c20d-us/Gnimu-PCB/README.md

<p>
  Gnimu icon
  <picture>
    <source media="(prefers-color-scheme: dark)" srcset="https://raw.githubusercontent.com/c20d-us/Gnimu-branding/main/wordmark/gnimu-wordmark-transparent-white.svg">
    gnimu
  </picture>
</p>

# Gnimu PCBs





Circuit boards for [Gnimu](https://github.com/c20d-us/Gnimu), a GNSS+IMU motorsports telemetry device that streams live position, speed, and motion data over BLE.

This repository holds the hardware only: KiCad projects, the shared symbol and footprint library, and fabrication outputs. The firmware, the bill of materials, and the step-by-step build guides live in the [Gnimu](https://github.com/c20d-us/Gnimu) repository.

<table>
  <tr>
    <td align="center" valign="top" width="50%">
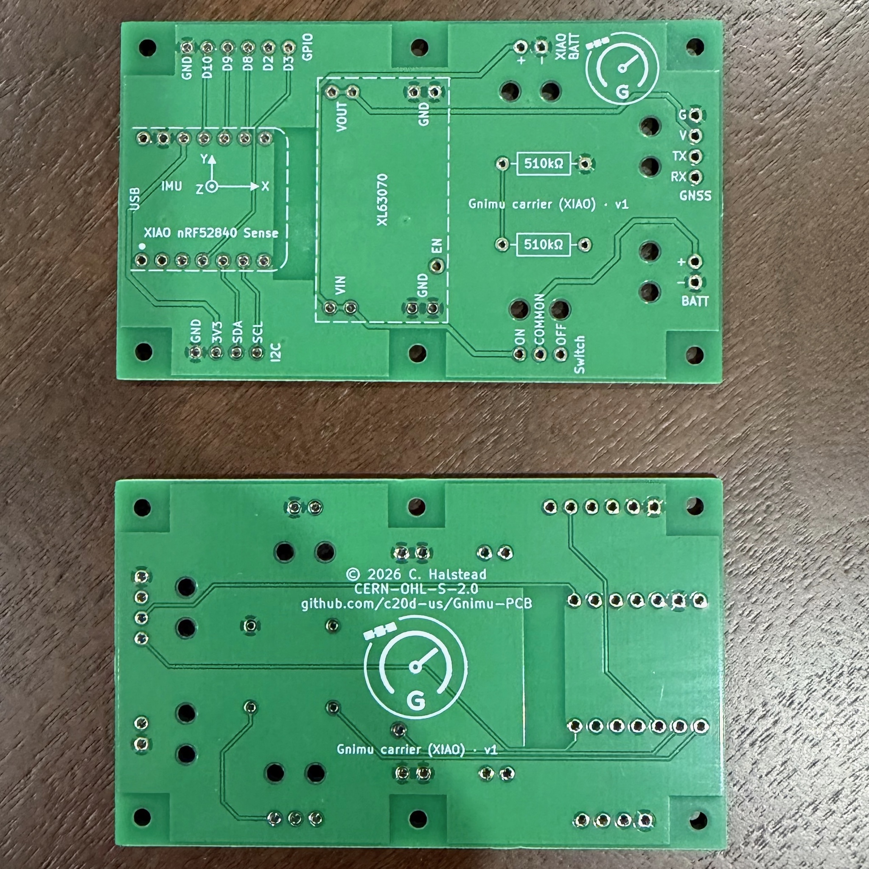
[picture p1: images/gnimu-carrier-xiao-v1-bare-pcb.jpeg]
The bare Gnimu carrier PCB, front and back
      <br>
      <sub>The bare carrier (revision v1.0), front and back.</sub>
    </td>
    <td align="center" valign="top" width="50%">
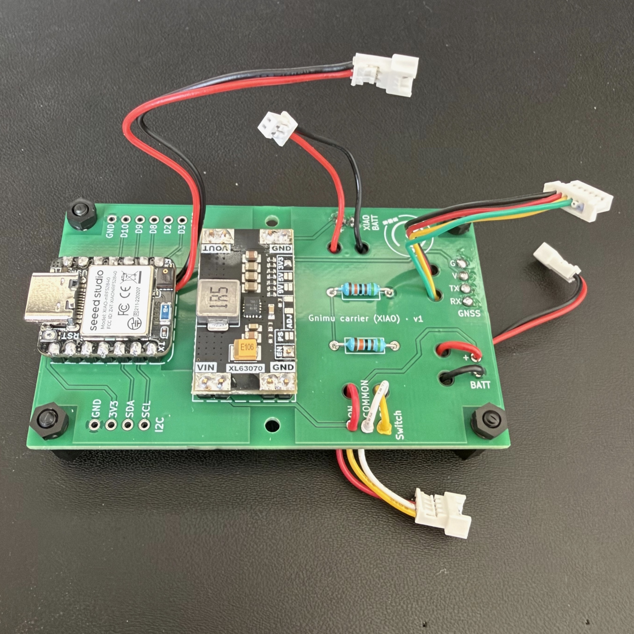
[picture p2: images/gnimu-carrier-xiao-v1-loaded-pcb.jpeg]
The Gnimu carrier PCB with the XIAO, regulator, resistors and leads fitted
      <br>
      <sub>Loaded: the XIAO, the XL63070 regulator, the two resistors, and leads.</sub>
    </td>
  </tr>
</table>

---

## Boards

| Board | Revision | MCU | Status |
|---|---|---|---|
| [**Gnimu carrier (XIAO)**](boards/gnimu/) | [v1.1](boards/gnimu/gnimu-carrier-xiao-v1.1/) | Seeed XIAO nRF52840 Sense | Current design. Gerbers not yet added. |
| | [v1.0](boards/gnimu/gnimu-carrier-xiao-v1.0/) | Seeed XIAO nRF52840 Sense | Fabricated and built. Gerbers included. |
| [**Gnimu-CAN OBD-II helper**](boards/gnimu-can/gnimu-can-obd-helper-v1.1/) | [v1.1](boards/gnimu-can/gnimu-can-obd-helper-v1.1/) | None | Layout complete. Not yet ordered. Swaps the 12V socket's pins to match stock leads. |
| | [v1.0](boards/gnimu-can/gnimu-can-obd-helper-v1.0/) | None | Ordered 2026-10-24. 12V socket pins reversed; see its README. |
| [**Gnimu-CAN carrier (XIAO)**](boards/gnimu-can/) | [LiPo v1.0](boards/gnimu-can/gnimu-can-carrier-xiao-lipo-v1.0/) | Seeed XIAO ESP32C6 | Layout complete. Not yet ordered. |
| | [12V v1.0](boards/gnimu-can/gnimu-can-carrier-xiao-12v-v1.0/) | Seeed XIAO ESP32C6 | Layout complete. Not yet ordered. |

Every board is two-layer and built for hand assembly. The carriers are through-hole only, built around off-the-shelf modules that solder straight onto them; the OBD-II helper adds one SOT-23 part.

---

## Repo layout

```
boards/
  gnimu/                 The GNSS+IMU carrier, one folder per revision
  gnimu-can/             Gnimu-CAN boards: the OBD-II helper and the LiPo and 12V CAN carriers (work in progress)
libraries/               Shared KiCad symbols (Gnimu.kicad_sym) and footprints (Gnimu.pretty)
silkscreen-logos/        The Gnimu logo as SVG, sized for silkscreen
images/                  Board photos
```

Each revision folder is a self-contained KiCad project. Where a revision has been sent out for fabrication, its `fabrication/` folder holds the gerbers as they were ordered.

---

## Opening the projects

The projects are KiCad 10 files. Clone the repository and open any `.kicad_pro`.

The custom parts come from [`libraries/`](libraries/), which each project finds through its own `sym-lib-table` and `fp-lib-table` using a path relative to the project. There is nothing to install or configure, provided the folder layout is kept as it is.

---

## License & Terms

This source describes Open Hardware and is licensed under [CERN-OHL-S v2][CERN-OHL-S_v2]. You may redistribute and modify this source and make products using it under the terms of this license. Please see the text of CERN-OHL-S v2 for all applicable conditions that apply.

This source is distributed WITHOUT ANY EXPRESS OR IMPLIED WARRANTY, INCLUDING OF MERCHANTABILITY, SATISFACTORY QUALITY AND FITNESS FOR A PARTICULAR PURPOSE.

The Gnimu firmware is a separate work under its own license; see the [Gnimu](https://github.com/c20d-us/Gnimu) repository.

The Gnimu name and logo, including the silkscreen logo on the boards, are not covered by this license. You may leave the logo on a board made from an unmodified design. If you modify a design, remove the logo. See the [Gnimu branding usage policy](https://github.com/c20d-us/Gnimu-branding/blob/main/LICENSE.md).

[CERN-OHL-S_v2]: https://ohwr.org/cern_ohl_s_v2.txt
