c20d-us/Gnimu-PCB/boards/gnimu-can/gnimu-can-carrier-xiao-12v-v1.0/gnimu-can-carrier-xiao-12v-v1.0.kicad_pcb

## KiCad design boards/gnimu-can/gnimu-can-carrier-xiao-12v-v1.0/gnimu-can-carrier-xiao-12v-v1.0.kicad_pcb (2026-11-07)

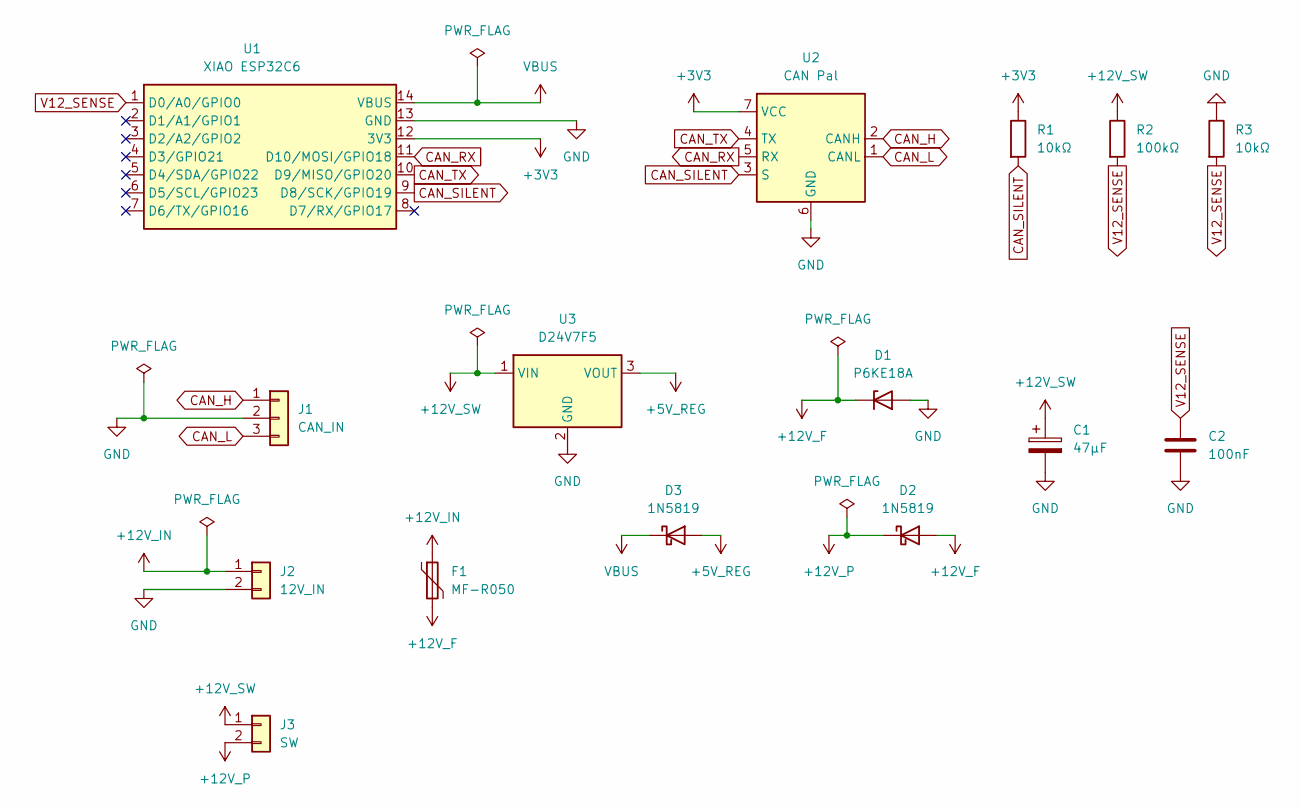
[picture p3: schematic gnimu-can-carrier-xiao-12v-v1.0.kicad_sch, Gnimu-CAN Carrier XIAO 12V]

Parts:
C1: 47µF; CP_Radial_D5.0mm_P2.00mm
C2: 100nF; C_Disc_D3.0mm_W2.0mm_P2.50mm
D1: P6KE18A; D_DO-15_P10.16mm_Horizontal
D2, D3: 1N5819; D_DO-41_SOD81_P10.16mm_Horizontal
F1: MF-R050; C_Disc_D7.5mm_W5.0mm_P5.00mm
J1: CAN_IN; Holes_1x03_P2.54mm
J2: 12V_IN; Holes_1x02_P2.54mm
J3: SW; Holes_1x02_P2.54mm
R1, R3: 10kΩ; R_Axial_DIN0207_L6.3mm_D2.5mm_P10.16mm_Horizontal
R2: 100kΩ; R_Axial_DIN0207_L6.3mm_D2.5mm_P10.16mm_Horizontal
U1: XIAO ESP32C6; XIAO_ESP32C6_THT
U2: CAN Pal; Adafruit_CAN_Pal_THT
U3: D24V7F5; Pololu_D24V7Fx_THT

Connections:
+3V3: R1.1, U1.12 (3V3), U2.7 (VCC)
+5V_REG: D3.2 (A), U3.3 (VOUT)
+12V_F: D1.1 (K), D2.2 (A), F1.2
+12V_IN: F1.1, J2.1
+12V_P: D2.1 (K), J3.2
+12V_SW: C1.1, J3.1, R2.1, U3.1 (VIN)
CAN_H: J1.1, U2.2 (CANH)
CAN_L: J1.3, U2.1 (CANL)
CAN_RX: U1.11 (D10/MOSI/GPIO18), U2.5 (RX)
CAN_SILENT: R1.2, U1.9 (D8/SCK/GPIO19), U2.3 (S)
CAN_TX: U1.10 (D9/MISO/GPIO20), U2.4 (TX)
GND: C1.2, C2.2, D1.2 (A), J1.2, J2.2, R3.1, U1.13 (GND), U2.6 (GND), U3.2 (GND)
V12_SENSE: C2.1, R2.2, R3.2, U1.1 (D0/A0/GPIO0)
VBUS: D3.1 (K), U1.14 (VBUS)

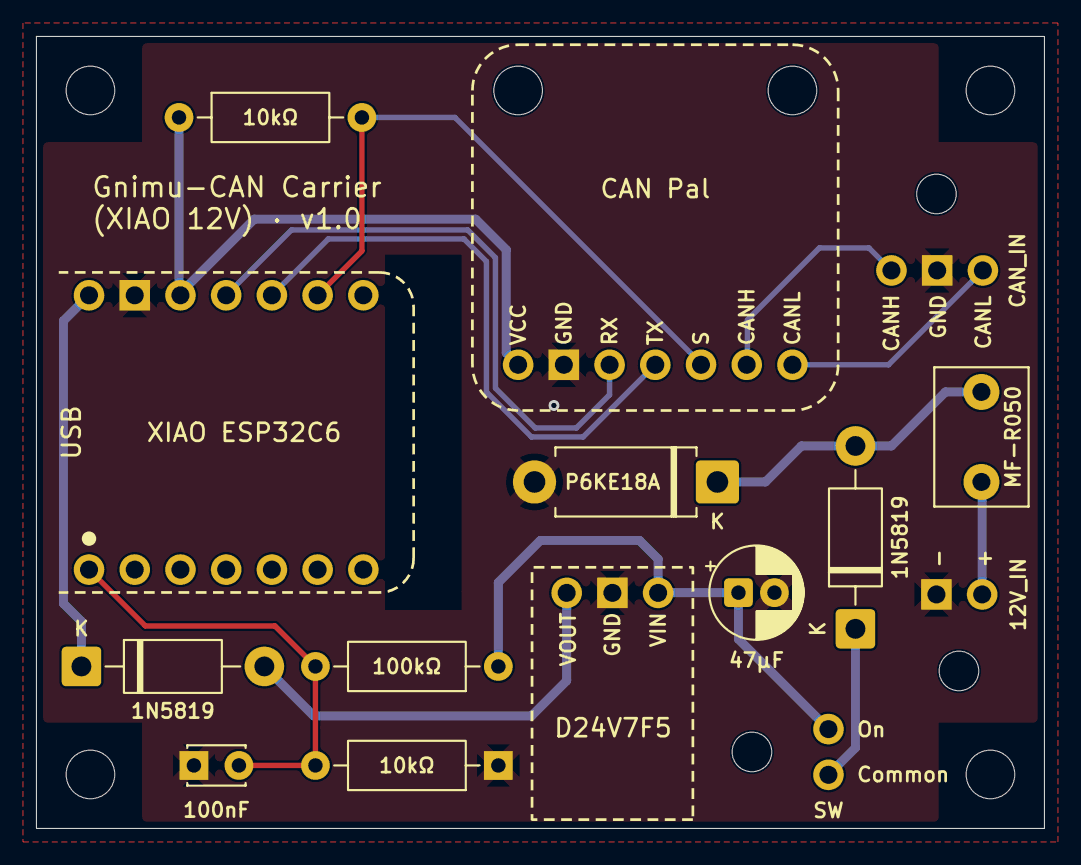
[picture p4: board gnimu-can-carrier-xiao-12v-v1.0.kicad_pcb from above]

Board: 2 copper layers, 56.0 x 44.0 mm, 22 parts (0 on the bottom side), 14 nets.

Other parts of the board:
M1: M1; MountingHole_2.7mm_M2.5
M2: M2; MountingHole_2.7mm_M2.5
M3: M3; MountingHole_2.7mm_M2.5
M4: M4; MountingHole_2.7mm_M2.5
SR1, SR2, SR3: MountingHole_2.2mm_M2
