c20d-us/Gnimu-PCB/boards/gnimu-can/gnimu-can-obd-helper-v1.1/gnimu-can-obd-helper-v1.1.kicad_pcb

## KiCad design boards/gnimu-can/gnimu-can-obd-helper-v1.1/gnimu-can-obd-helper-v1.1.kicad_pcb (2026-11-07)

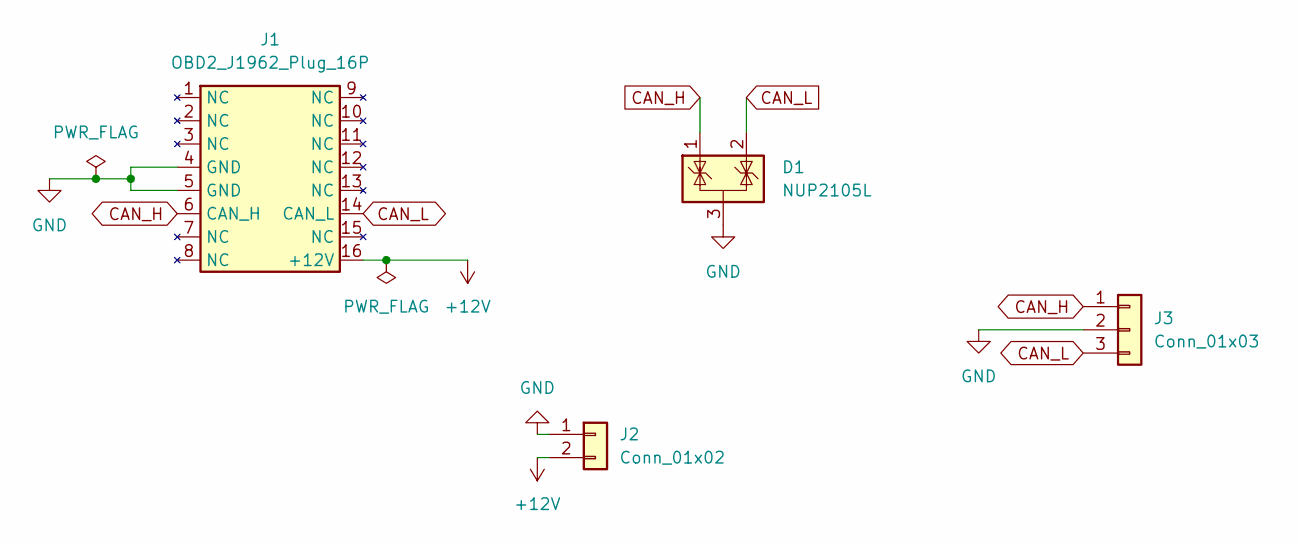
[picture p5: schematic gnimu-can-obd-helper-v1.1.kicad_sch, Gnimu-CAN OBD-II Helper Board]

Parts:
D1: NUP2105L; SOT-23
J1: OBD2_J1962_Plug_16P; OBD2_J1962_Plug_Straight_16P
J2: Conn_01x02; JST_PH_B2B-PH-K_1x02_P2.00mm_Vertical
J3: Conn_01x03; JST_PH_B3B-PH-K_1x03_P2.00mm_Vertical

Connections:
+12V: J1.16 (+12V), J2.2
CAN_H: D1.1 (K), J1.6 (CAN_H), J3.1
CAN_L: D1.2 (K), J1.14 (CAN_L), J3.3
GND: D1.3 (A), J1.4 (GND), J1.5 (GND), J2.1, J3.2

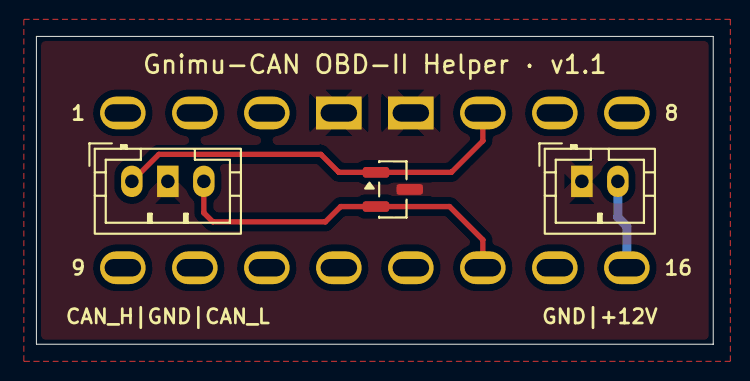
[picture p6: board gnimu-can-obd-helper-v1.1.kicad_pcb from above]

Board: 2 copper layers, 37.6 x 17.1 mm, 4 parts (0 on the bottom side), 4 nets.
