c20d-us/Gnimu-PCB/boards/gnimu/gnimu-carrier-xiao-v1.0/gnimu-carrier-xiao-v1.0.kicad_pcb

## KiCad design boards/gnimu/gnimu-carrier-xiao-v1.0/gnimu-carrier-xiao-v1.0.kicad_pcb (2026-11-06, an earlier design)

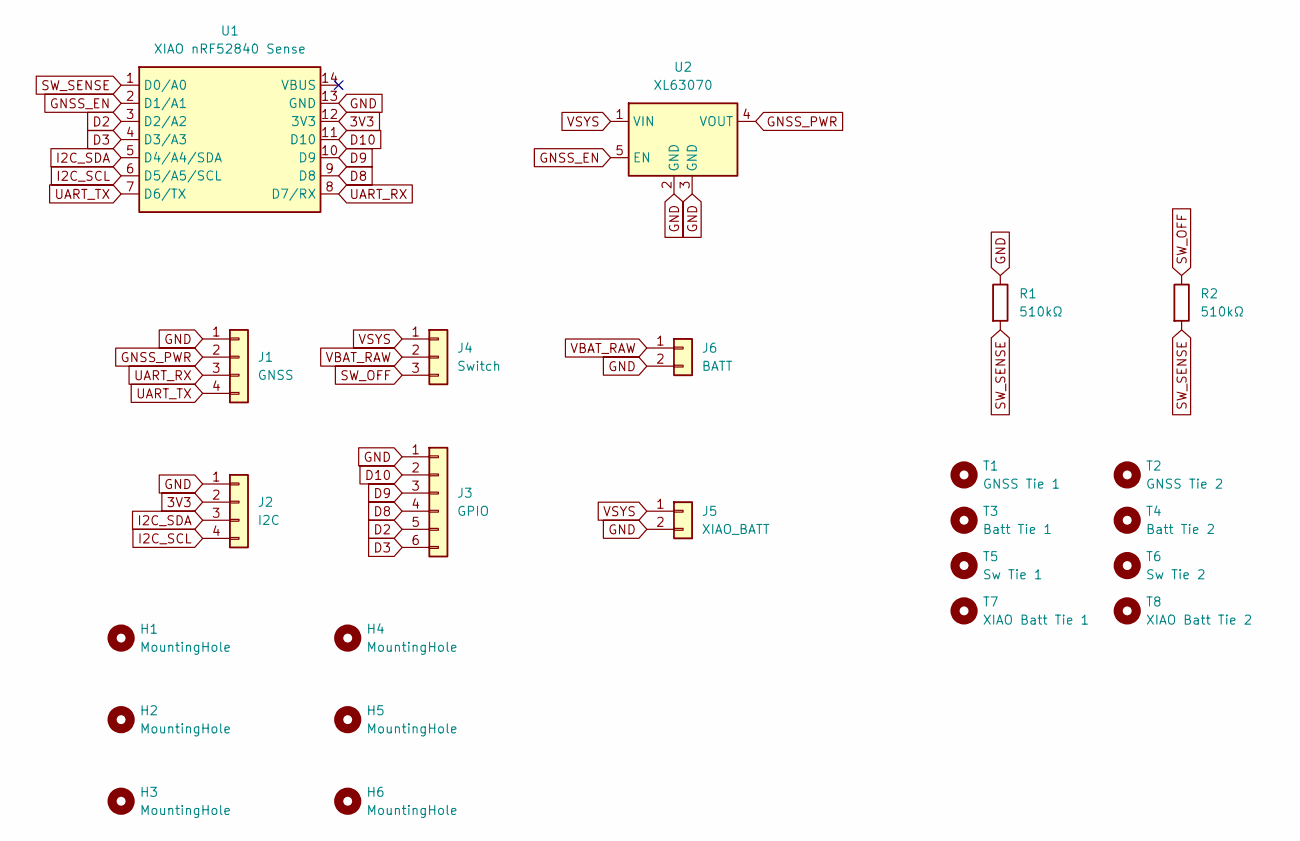
[picture p7: schematic gnimu-carrier-xiao-v1.0.kicad_sch, Gnimu GNSS+IMU carrier board (XIAO)]

Parts:
H1, H2, H3, H4, H5, H6: MountingHole; MountingHole_2.2mm_M2
J1: GNSS; Holes_1x04_P2.54mm
J2: I2C; Holes_1x04_P2.54mm
J3: GPIO; Holes_1x06_P2.54mm
J4: Switch; Holes_1x03_P2.54mm
J5: XIAO_BATT; Holes_1x02_P2.54mm
J6: BATT; Holes_1x02_P2.54mm
R1, R2: 510kΩ; R_Axial_DIN0207_L6.3mm_D2.5mm_P10.16mm_Horizontal
T1: GNSS Tie 1; MountingHole_2.2mm_M2
T2: GNSS Tie 2; MountingHole_2.2mm_M2
T3: Batt Tie 1; MountingHole_2.2mm_M2
T4: Batt Tie 2; MountingHole_2.2mm_M2
T5: Sw Tie 1; MountingHole_2.2mm_M2
T6: Sw Tie 2; MountingHole_2.2mm_M2
T7: XIAO Batt Tie 1; MountingHole_2.2mm_M2
T8: XIAO Batt Tie 2; MountingHole_2.2mm_M2
U1: XIAO nRF52840 Sense; XIAO_nRF52840_THT
U2: XL63070; XL63070_THT

Connections:
3V3: J2.2, U1.12 (3V3)
D2: J3.5, U1.3 (D2/A2)
D3: J3.6, U1.4 (D3/A3)
D8: J3.4, U1.9 (D8)
D9: J3.3, U1.10 (D9)
D10: J3.2, U1.11 (D10)
GND: J1.1, J2.1, J3.1, J5.2, J6.2, R1.1, U1.13 (GND), U2.2 (GND), U2.3 (GND)
GNSS_EN: U1.2 (D1/A1), U2.5 (EN)
GNSS_PWR: J1.2, U2.4 (VOUT)
I2C_SCL: J2.4, U1.6 (D5/A5/SCL)
I2C_SDA: J2.3, U1.5 (D4/A4/SDA)
SW_OFF: J4.3, R2.1
SW_SENSE: R1.2, R2.2, U1.1 (D0/A0)
UART_RX: J1.3, U1.8 (D7/RX)
UART_TX: J1.4, U1.7 (D6/TX)
VBAT_RAW: J4.2, J6.1
VSYS: J4.1, J5.1, U2.1 (VIN)

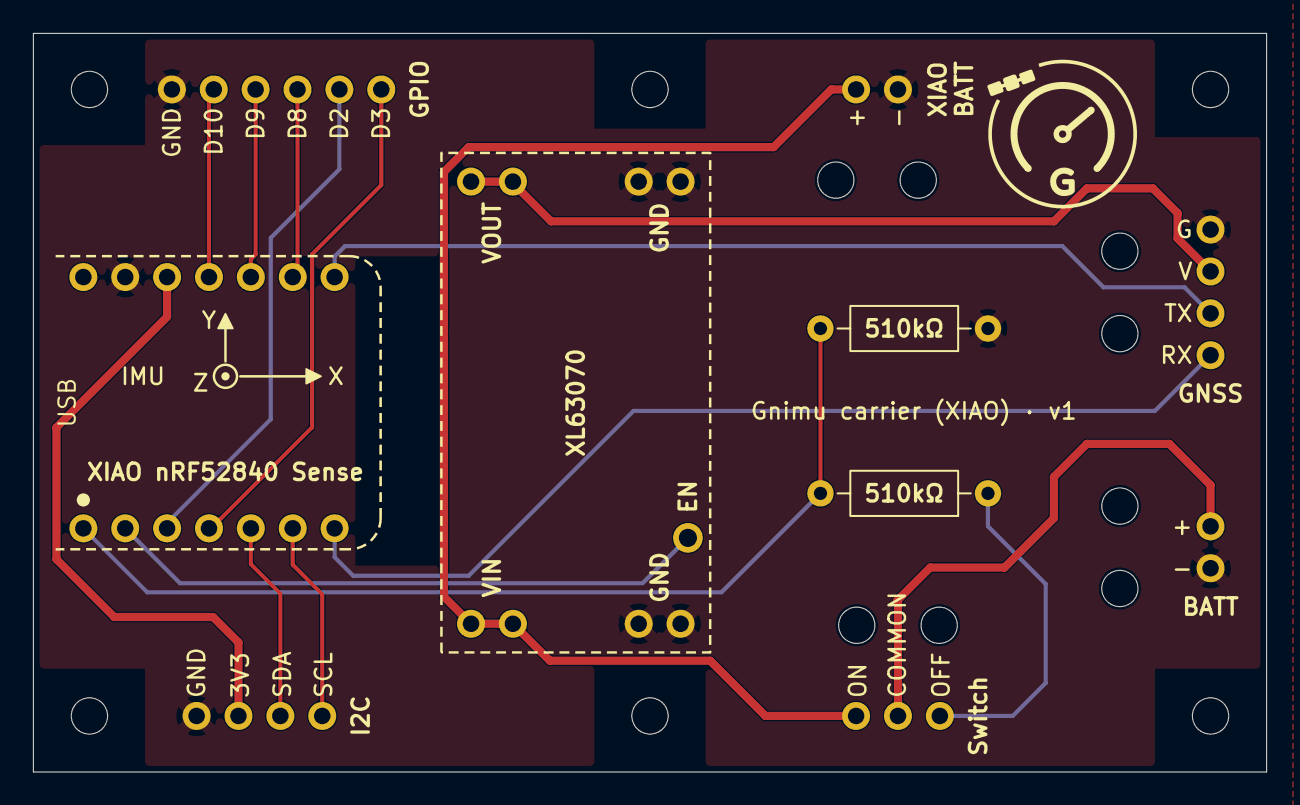
[picture p8: board gnimu-carrier-xiao-v1.0.kicad_pcb from above]

Board: 2 copper layers, 74.8 x 44.8 mm, 24 parts (0 on the bottom side), 17 nets.
