c20d-us/Gnimu-PCB/(commit log)

2026-09-29 xiao-v1 complete
    [gnimu-carrier-xiao-v1.kicad_pcb, gnimu-carrier-xiao-v1.kicad_sch]
2026-10-12 repo reorganization
    [gnimi-can-xiao-v1.kicad_sch, gnimu-can-xiao-v1.kicad_pcb, gnimu-can-xiao-v1.kicad_sch, gnimu-carrier-xiao-v1.1.kicad_pcb, gnimu-carrier-xiao-v1.1.kicad_sch, gnimu-carrier-xiao-v1.kicad_pcb, gnimu-carrier-xiao-v1.kicad_sch]
2026-10-25 CAN XIAO carrier: first complete layout
    [gnimu-can-carrier-xiao-v1.kicad_pcb, gnimu-can-carrier-xiao-v1.kicad_sch, gnimu-can-obd-helper-v1.kicad_pcb, gnimu-can-obd-helper-v1.kicad_sch, gnimu-can-xiao-v1.kicad_pcb, gnimu-can-xiao-v1.kicad_sch]
2026-10-29 Gnimu-CAN additions
    [gnimu-can-carrier-xiao-12v-v1.kicad_pcb, gnimu-can-carrier-xiao-12v-v1.kicad_sch, gnimu-can-carrier-xiao-lipo-v1.kicad_pcb, gnimu-can-carrier-xiao-lipo-v1.kicad_sch, gnimu-can-carrier-xiao-v1.kicad_pcb]
2026-10-30 minor trace tweaks
    [gnimu-can-carrier-xiao-12v-v1.kicad_pcb]
2026-11-06 version numbering consistency
    [gnimu-can-carrier-xiao-12v-v1.0.kicad_pcb, gnimu-can-carrier-xiao-12v-v1.0.kicad_sch, gnimu-can-carrier-xiao-12v-v1.kicad_pcb, gnimu-can-carrier-xiao-lipo-v1.0.kicad_pcb, gnimu-can-carrier-xiao-lipo-v1.0.kicad_sch, gnimu-can-obd-helper-v1.0.kicad_pcb, gnimu-can-obd-helper-v1.0.kicad_sch, gnimu-can-obd-helper-v1.1.kicad_pcb]
2026-11-07 Minor tweaks
    [gnimu-can-obd-helper-v1.1.kicad_pcb]
2026-11-07 add ordered gerbers
    [gnimu-can-carrier-xiao-12v-v1.0.kicad_pcb]
