c20d-us/Gnimu-PCB/(notices)

Notices in the files:
boards/gnimu/gnimu-carrier-xiao-v1.1/gnimu-carrier-xiao-v1.1.kicad_pcb:
© 2026 C. Halstead
CERN-OHL-S-2.0
README.md:
License: CERN-OHL-S-2.0
